mgamota2/ECE427/bringup/media/socket_pcb.jpg

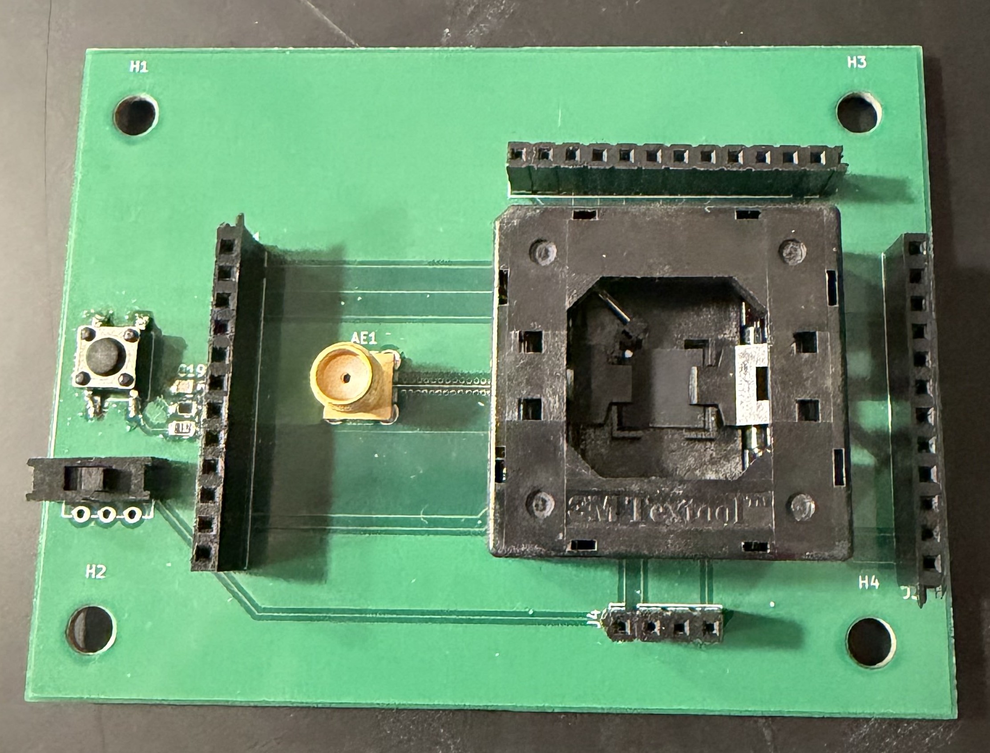
bringup/media/socket_pcb.jpg
