mgamota2/ECE427/bringup/media/distribution_stream.jpg

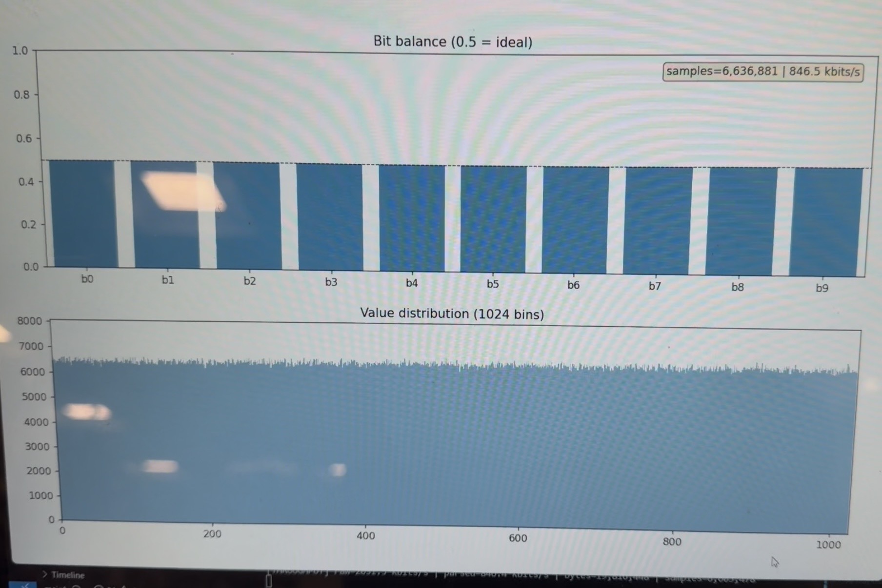
bringup/media/distribution_stream.jpg
