mgamota2/ECE427/bringup/media/legend_gui.png

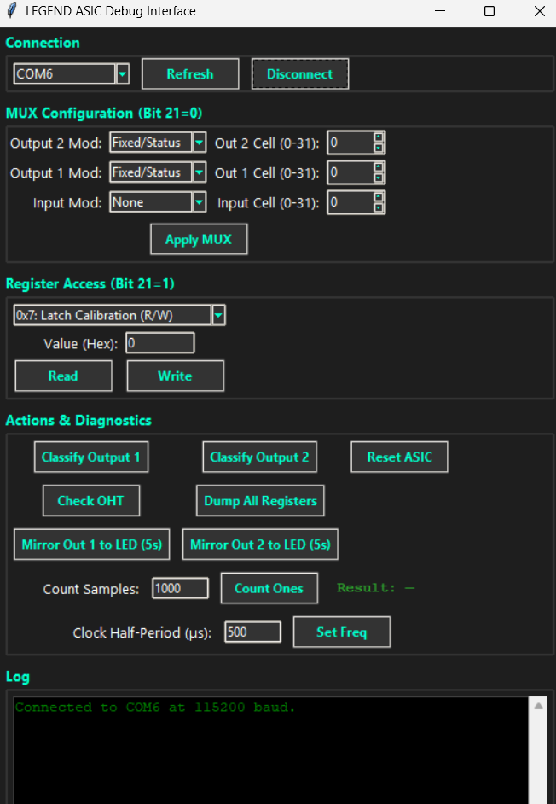
bringup/media/legend_gui.png
