mgamota2/ECE427/bringup/media/pcb_off.jpeg

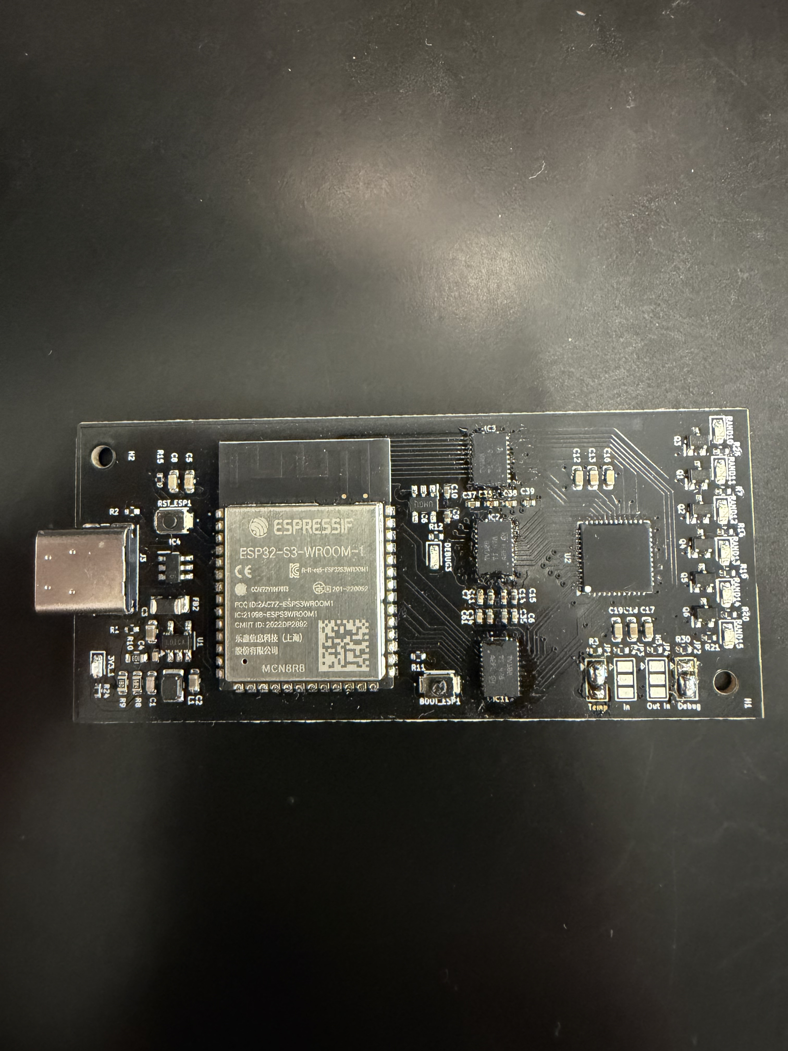
bringup/media/pcb_off.jpeg
