mgamota2/ECE427/bringup/esp32xlegend/esp32xlegend/esp32xlegend.kicad_pcb

## KiCad design bringup/esp32xlegend/esp32xlegend/esp32xlegend.kicad_pcb (2026-06-03)

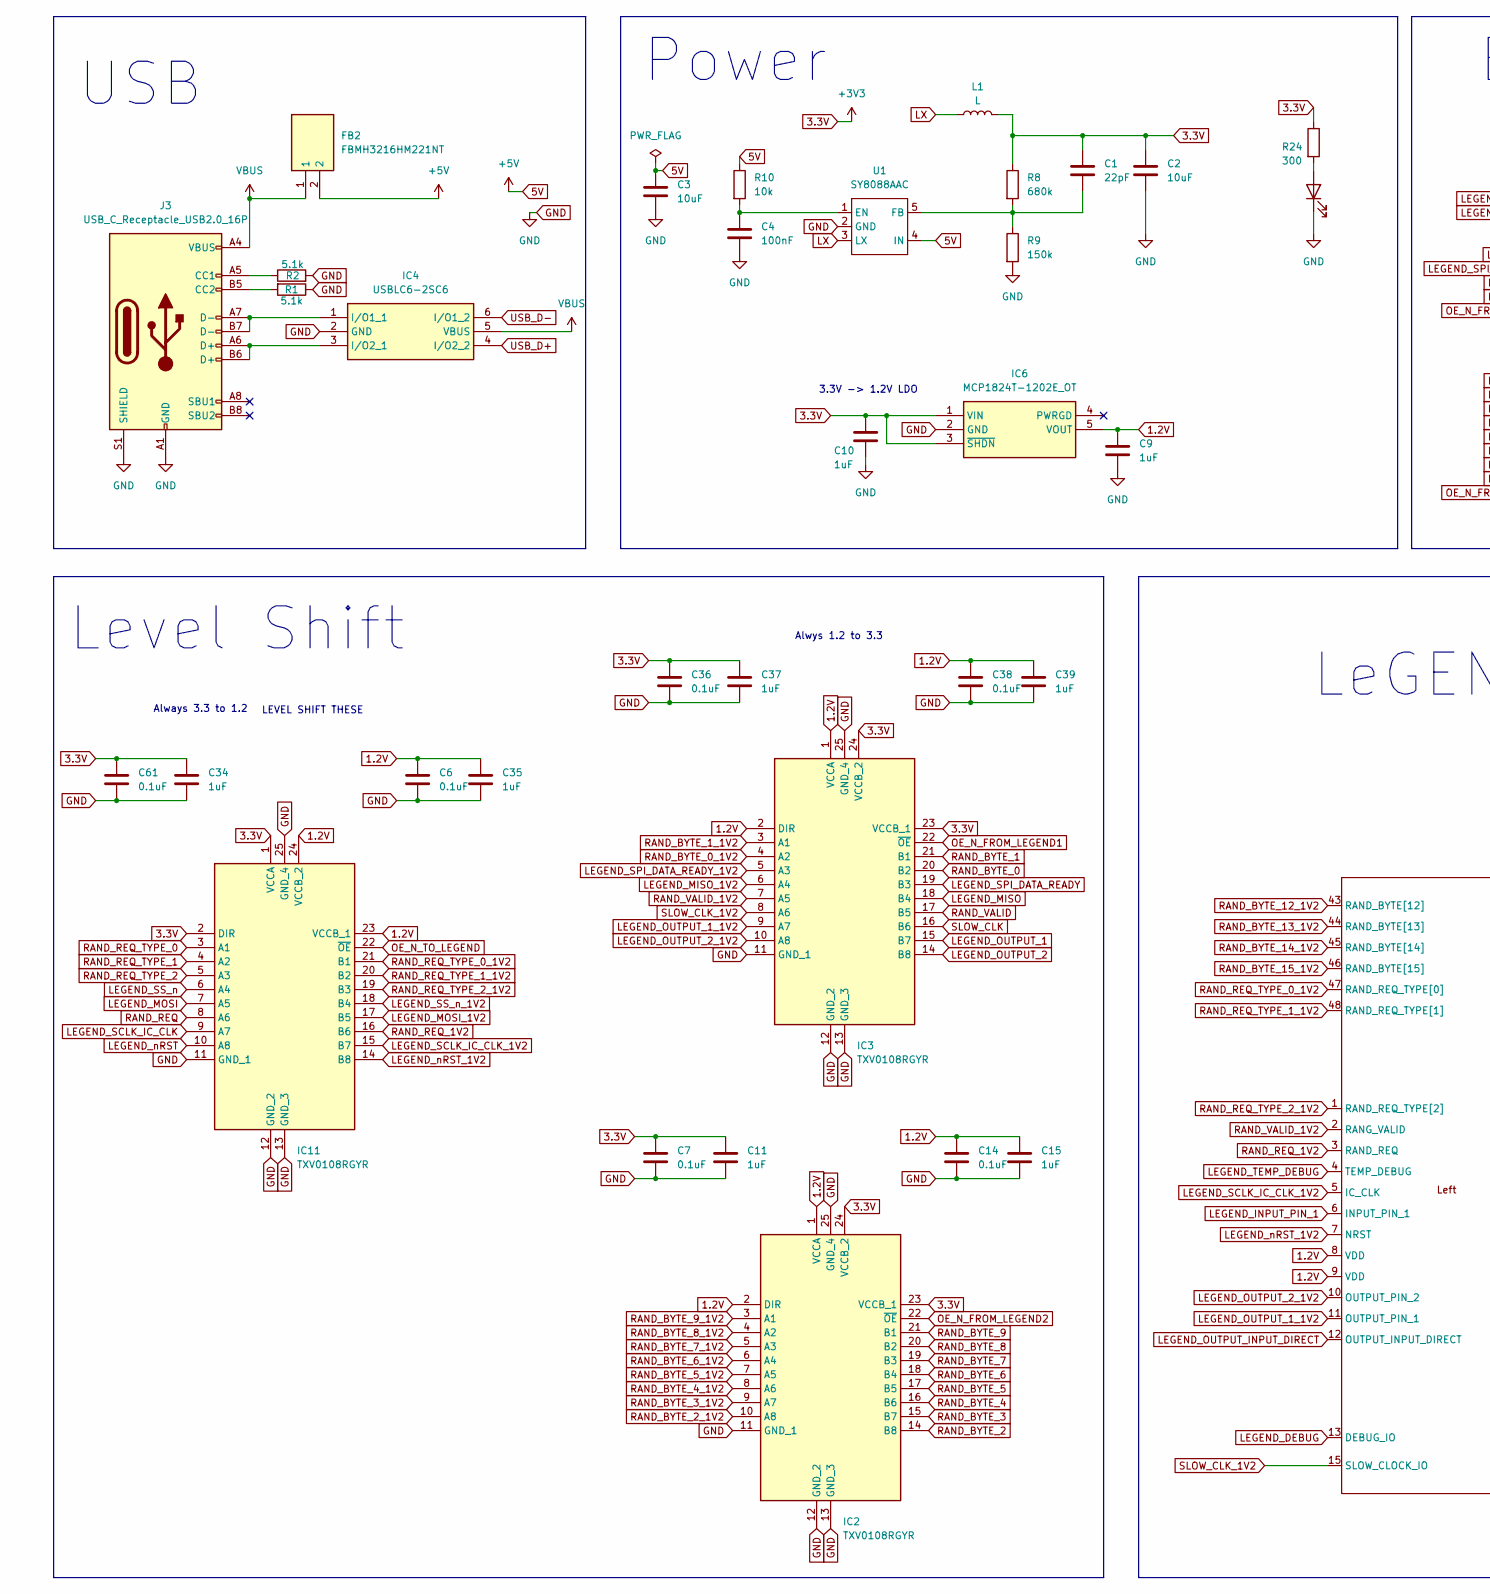
[picture p22: schematic esp32xlegend.kicad_sch, part in row 1, column 1]

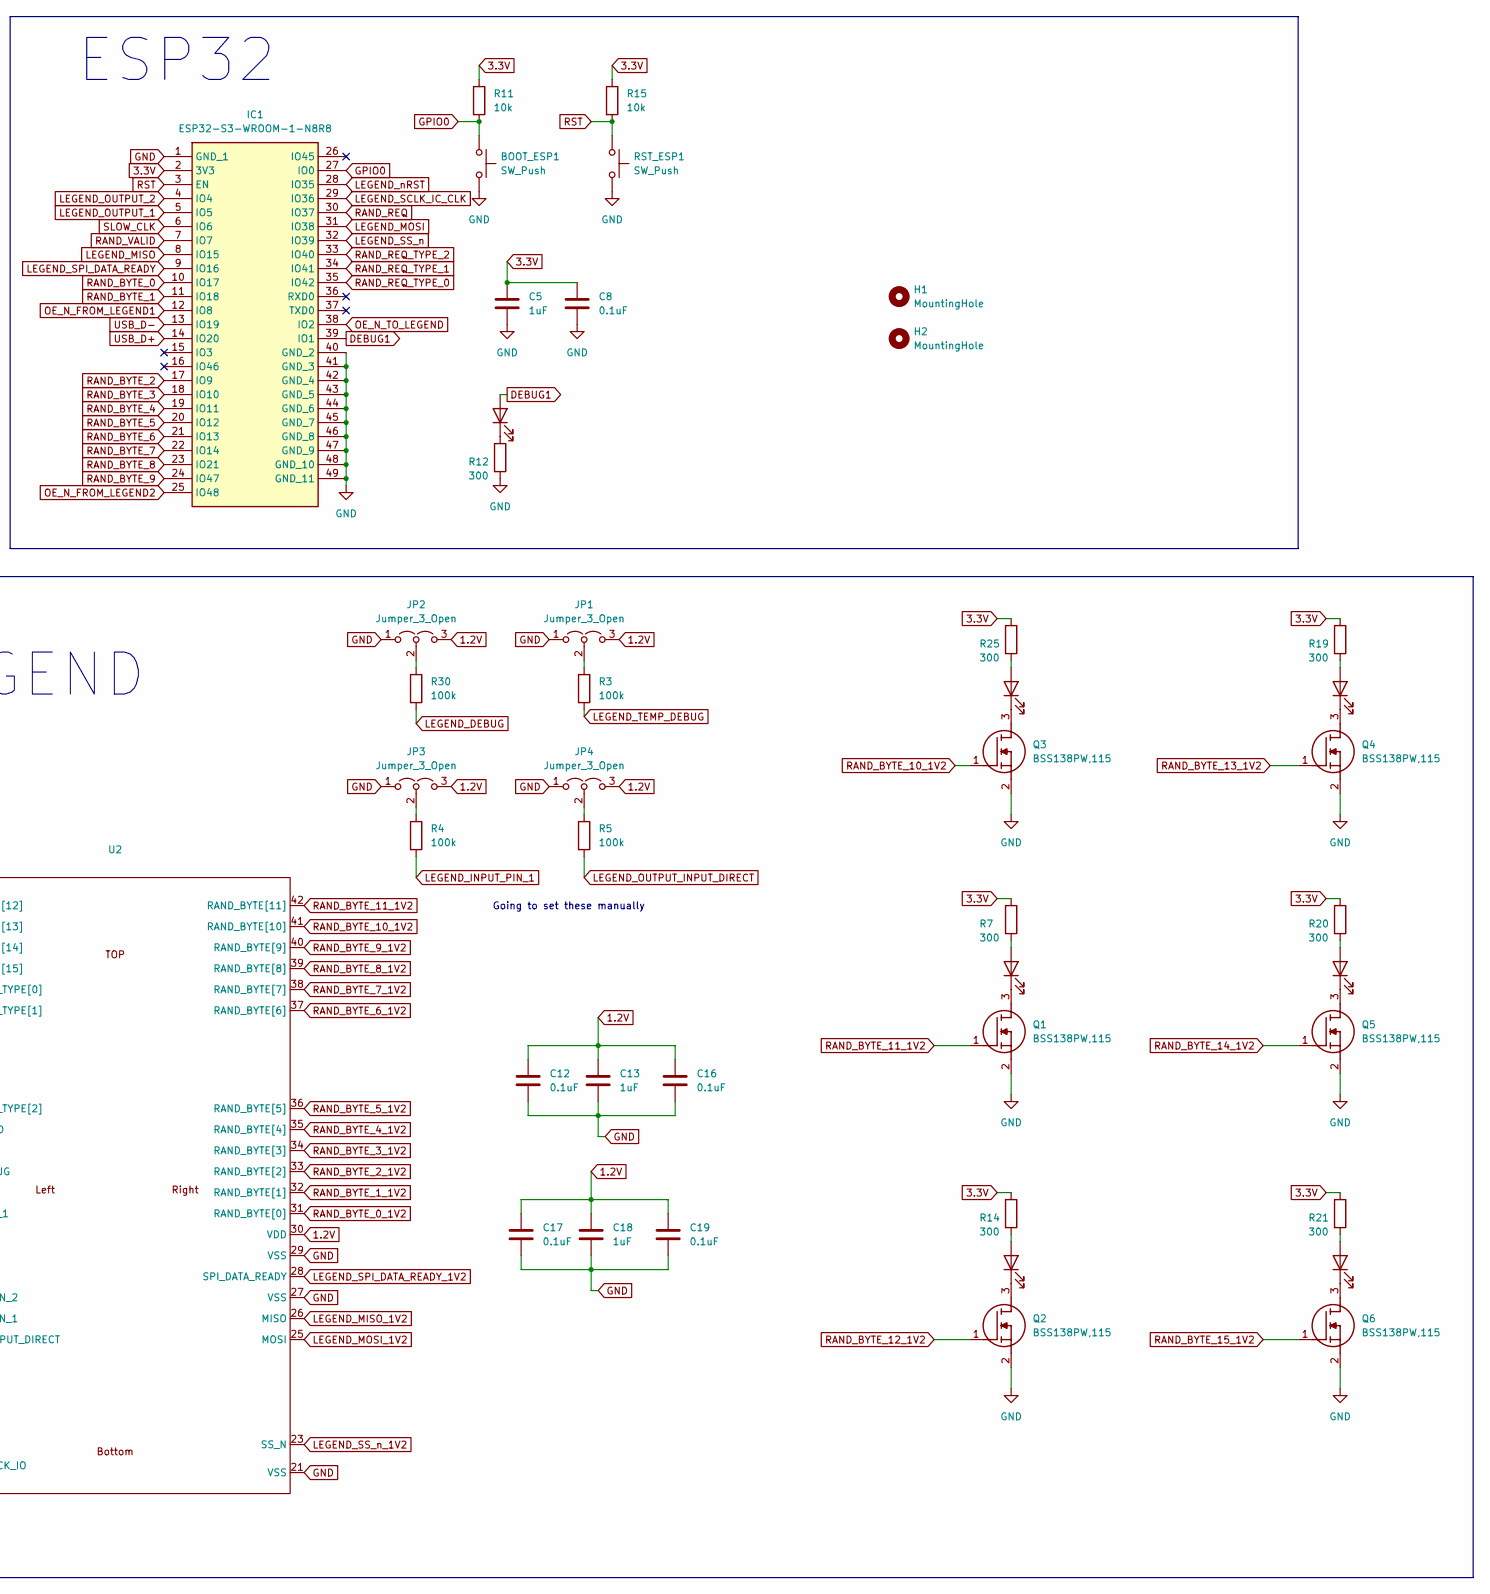
[picture p23: schematic esp32xlegend.kicad_sch, part in row 1, column 2]

Parts:
3V3_1: LED; LED_0603_1608Metric
BOOT_ESP1: SW_Push; B3U1000PM
C1: 22pF; C_0603_1608Metric
C2, C3: 10uF; C_0603_1608Metric
C4: 100nF; C_0402_1005Metric
C5, C13, C18: 1uF; C_0603_1608Metric
C6, C7, C14, C36, C38, C61: 0.1uF; C_0402_1005Metric
C8, C12, C16, C17, C19: 0.1uF; C_0603_1608Metric
C9, C10, C11, C15, C34, C35, C37, C39: 1uF; C_0402_1005Metric
DEBUG3: LED; LED_0603_1608Metric
FB2: FBMH3216HM221NT; BEADC3216X180N; Mouser Part Number 963-FBMH3216HM221NT
H1, H2: MountingHole; MountingHole_2.2mm_M2
IC1: ESP32-S3-WROOM-1-N8R8; ESP32S3WROOM1N8R8; Mouser Part Number 356-EP32S3WROOM1N8R8
IC2, IC3, IC11: TXV0108RGYR; Mouser Part Number 595-TXV0108RGYR
IC4: USBLC6-2SC6; SOT95P280X145-6N; Mouser Part Number 511-USBLC6-2SC6
IC6: MCP1824T-1202E_OT; SOT95P270X145-5N; Mouser Part Number 579-MCP1824T-1202EOT
J3: USB_C_Receptacle_USB2.0_16P; USB_C_Receptacle_GCT_USB4085
JP1, JP2, JP3, JP4: Jumper_3_Open; SolderJumper-3_P1.3mm_Open_Pad1.0x1.5mm
L1: L; L_1008_2520Metric
Q1, Q2, Q3, Q4, Q5, Q6: BSS138PW,115; SOT65P210X110-3N; Mouser Part Number 771-BSS138PW115
R1, R2: 5.1k; R_0402_1005Metric
R3, R4, R5, R30: 100k; R_0402_1005Metric
R7, R12, R14, R19, R20, R21, R24, R25: 300; R_0402_1005Metric
R8: 680k; R_0603_1608Metric
R9: 150k; R_0603_1608Metric
R10: 10k; R_0603_1608Metric
R11, R15: 10k; R_0402_1005Metric
RAND10, RAND11, RAND12, RAND13, RAND14, RAND15: LED; LED_0603_1608Metric
RST_ESP1: SW_Push; B3U1000PM
U1: SY8088AAC; SOT-23-5_HandSoldering
U2: CHIP

Connections:
1.2V: C6.1, C9.1, C12.1, C13.1, C14.1, C15.1, C16.1, C17.1, C18.1, C19.1, C35.1, C38.1, C39.1, IC2.1 (VCCA), IC2.2 (DIR), IC3.1 (VCCA), IC3.2 (DIR), IC6.5 (VOUT), IC11.23 (VCCB_1), IC11.24 (VCCB_2), JP1.3 (B), JP2.3 (B), JP3.3 (B), JP4.3 (B), U2.8 (VDD), U2.9 (VDD), U2.30 (VDD)
3.3V: C1.1, C2.1, C5.1, C7.1, C8.1, C10.1, C11.1, C34.1, C36.1, C37.1, C61.1, IC1.2 (3V3), IC2.23 (VCCB_1), IC2.24 (VCCB_2), IC3.23 (VCCB_1), IC3.24 (VCCB_2), IC6.1 (VIN), IC6.3 (~SHDN), IC11.1 (VCCA), IC11.2 (DIR), L1.2, R7.1, R8.1, R11.1, R14.1, R15.1, R19.1, R20.1, R21.1, R24.1, R25.1
5V: C3.1, FB2.2, R10.1, U1.4 (IN)
DEBUG1: DEBUG3.2 (A), IC1.39 (IO1)
GND: 3V3_1.1 (K), BOOT_ESP1.2, C2.2, C3.2, C4.2, C5.2, C6.2, C7.2, C8.2, C9.2, C10.2, C11.2, C12.2, C13.2, C14.2, C15.2, C16.2, C17.2, C18.2, C19.2, C34.2, C35.2, C36.2, C37.2, C38.2, C39.2, C61.2, IC1.1 (GND_1), IC1.40 (GND_2), IC1.41 (GND_3), IC1.42 (GND_4), IC1.43 (GND_5), IC1.44 (GND_6), IC1.45 (GND_7), IC1.46 (GND_8), IC1.47 (GND_9), IC1.48 (GND_10), IC1.49 (GND_11), IC2.11 (GND_1), IC2.12 (GND_2), IC2.13 (GND_3), IC2.25 (GND_4), IC3.11 (GND_1), IC3.12 (GND_2), IC3.13 (GND_3), IC3.25 (GND_4), IC4.2 (GND), IC6.2 (GND), IC11.11 (GND_1), IC11.12 (GND_2), IC11.13 (GND_3), IC11.25 (GND_4), J3.A1 (GND), J3.A12 (GND), J3.B1 (GND), J3.B12 (GND), J3.S1 (SHIELD), JP1.1 (A), JP2.1 (A), JP3.1 (A), JP4.1 (A), Q1.2 (S), Q2.2 (S), Q3.2 (S), Q4.2 (S), Q5.2 (S), Q6.2 (S), R1.1, R2.2, R9.2, R12.2, RST_ESP1.2, U1.2 (GND), U2.21 (VSS), U2.27 (VSS), U2.29 (VSS)
GPIO0: BOOT_ESP1.1, IC1.27 (IO0), R11.2
LEGEND_DEBUG: R30.2, U2.13 (DEBUG_IO)
LEGEND_INPUT_PIN_1: R4.2, U2.6 (INPUT_PIN_1)
LEGEND_MISO: IC1.8 (IO15), IC3.18 (B4)
LEGEND_MISO_1V2: IC3.6 (A4), U2.26 (MISO)
LEGEND_MOSI: IC1.31 (IO38), IC11.7 (A5)
LEGEND_MOSI_1V2: IC11.17 (B5), U2.25 (MOSI)
LEGEND_OUTPUT_1: IC1.5 (IO5), IC3.15 (B7)
LEGEND_OUTPUT_1_1V2: IC3.9 (A7), U2.11 (OUTPUT_PIN_1)
LEGEND_OUTPUT_2: IC1.4 (IO4), IC3.14 (B8)
LEGEND_OUTPUT_2_1V2: IC3.10 (A8), U2.10 (OUTPUT_PIN_2)
LEGEND_OUTPUT_INPUT_DIRECT: R5.2, U2.12 (OUTPUT_INPUT_DIRECT)
LEGEND_SCLK_IC_CLK: IC1.29 (IO36), IC11.9 (A7)
LEGEND_SCLK_IC_CLK_1V2: IC11.15 (B7), U2.5 (IC_CLK)
LEGEND_SPI_DATA_READY: IC1.9 (IO16), IC3.19 (B3)
LEGEND_SPI_DATA_READY_1V2: IC3.5 (A3), U2.28 (SPI_DATA_READY)
LEGEND_SS_n: IC1.32 (IO39), IC11.6 (A4)
LEGEND_SS_n_1V2: IC11.18 (B4), U2.23 (SS_N)
LEGEND_TEMP_DEBUG: R3.2, U2.4 (TEMP_DEBUG)
LEGEND_nRST: IC1.28 (IO35), IC11.10 (A8)
LEGEND_nRST_1V2: IC11.14 (B8), U2.7 (NRST)
LX: L1.1, U1.3 (LX)
unnamed: 3V3_1.2 (A), R24.2
unnamed: DEBUG3.1 (K), R12.1
unnamed: IC4.1 (I/O1_1), J3.A7 (D-), J3.B7 (D-)
unnamed: IC4.3 (I/O2_1), J3.A6 (D+), J3.B6 (D+)
unnamed: J3.A5 (CC1), R2.1
unnamed: J3.B5 (CC2), R1.2
unnamed: JP1.2 (C), R3.1
unnamed: JP2.2 (C), R30.1
unnamed: JP3.2 (C), R4.1
unnamed: JP4.2 (C), R5.1
unnamed: Q1.3 (D), RAND11.1 (K)
unnamed: Q2.3 (D), RAND12.1 (K)
unnamed: Q3.3 (D), RAND10.1 (K)
unnamed: Q4.3 (D), RAND13.1 (K)
unnamed: Q5.3 (D), RAND14.1 (K)
unnamed: Q6.3 (D), RAND15.1 (K)
unnamed: R25.2, RAND10.2 (A)
unnamed: R7.2, RAND11.2 (A)
unnamed: R14.2, RAND12.2 (A)
unnamed: R19.2, RAND13.2 (A)
unnamed: R20.2, RAND14.2 (A)
unnamed: R21.2, RAND15.2 (A)
unnamed: C4.1, R10.2, U1.1 (EN)
unnamed: C1.2, R8.2, R9.1, U1.5 (FB)
OE_N_FROM_LEGEND1: IC1.12 (IO8), IC3.22 (~OE)
OE_N_FROM_LEGEND2: IC1.25 (IO48), IC2.22 (~OE)
OE_N_TO_LEGEND: IC1.38 (IO2), IC11.22 (~OE)
RAND_BYTE_0: IC1.10 (IO17), IC3.20 (B2)
RAND_BYTE_0_1V2: IC3.4 (A2), U2.31 (RAND_BYTE[0])
RAND_BYTE_1: IC1.11 (IO18), IC3.21 (B1)
RAND_BYTE_1_1V2: IC3.3 (A1), U2.32 (RAND_BYTE[1])
RAND_BYTE_2: IC1.17 (IO9), IC2.14 (B8)
RAND_BYTE_2_1V2: IC2.10 (A8), U2.33 (RAND_BYTE[2])
RAND_BYTE_3: IC1.18 (IO10), IC2.15 (B7)
RAND_BYTE_3_1V2: IC2.9 (A7), U2.34 (RAND_BYTE[3])
RAND_BYTE_4: IC1.19 (IO11), IC2.16 (B6)
RAND_BYTE_4_1V2: IC2.8 (A6), U2.35 (RAND_BYTE[4])
RAND_BYTE_5: IC1.20 (IO12), IC2.17 (B5)
RAND_BYTE_5_1V2: IC2.7 (A5), U2.36 (RAND_BYTE[5])
RAND_BYTE_6: IC1.21 (IO13), IC2.18 (B4)
RAND_BYTE_6_1V2: IC2.6 (A4), U2.37 (RAND_BYTE[6])
RAND_BYTE_7: IC1.22 (IO14), IC2.19 (B3)
RAND_BYTE_7_1V2: IC2.5 (A3), U2.38 (RAND_BYTE[7])
RAND_BYTE_8: IC1.23 (IO21), IC2.20 (B2)
RAND_BYTE_8_1V2: IC2.4 (A2), U2.39 (RAND_BYTE[8])
RAND_BYTE_9: IC1.24 (IO47), IC2.21 (B1)
RAND_BYTE_9_1V2: IC2.3 (A1), U2.40 (RAND_BYTE[9])
RAND_BYTE_10_1V2: Q3.1 (G), U2.41 (RAND_BYTE[10])
RAND_BYTE_11_1V2: Q1.1 (G), U2.42 (RAND_BYTE[11])
RAND_BYTE_12_1V2: Q2.1 (G), U2.43 (RAND_BYTE[12])
RAND_BYTE_13_1V2: Q4.1 (G), U2.44 (RAND_BYTE[13])
RAND_BYTE_14_1V2: Q5.1 (G), U2.45 (RAND_BYTE[14])
RAND_BYTE_15_1V2: Q6.1 (G), U2.46 (RAND_BYTE[15])
RAND_REQ: IC1.30 (IO37), IC11.8 (A6)
RAND_REQ_1V2: IC11.16 (B6), U2.3 (RAND_REQ)
RAND_REQ_TYPE_0: IC1.35 (IO42), IC11.3 (A1)
RAND_REQ_TYPE_0_1V2: IC11.21 (B1), U2.47 (RAND_REQ_TYPE[0])
RAND_REQ_TYPE_1: IC1.34 (IO41), IC11.4 (A2)
RAND_REQ_TYPE_1_1V2: IC11.20 (B2), U2.48 (RAND_REQ_TYPE[1])
RAND_REQ_TYPE_2: IC1.33 (IO40), IC11.5 (A3)
RAND_REQ_TYPE_2_1V2: IC11.19 (B3), U2.1 (RAND_REQ_TYPE[2])
RAND_VALID: IC1.7 (IO7), IC3.17 (B5)
RAND_VALID_1V2: IC3.7 (A5), U2.2 (RANG_VALID)
RST: IC1.3 (EN), R15.2, RST_ESP1.1
SLOW_CLK: IC1.6 (IO6), IC3.16 (B6)
SLOW_CLK_1V2: IC3.8 (A6), U2.15 (SLOW_CLOCK_IO)
USB_D+: IC1.14 (IO20), IC4.4 (I/O2_2)
USB_D-: IC1.13 (IO19), IC4.6 (I/O1_2)
VBUS: FB2.1, IC4.5 (VBUS), J3.A4 (VBUS), J3.A9 (VBUS), J3.B4 (VBUS), J3.B9 (VBUS)

Notes on the sheet:
3.3V -> 1.2V LDO
Power
ESP32
LEVEL SHIFT THESE
Level Shift
Going to set these manually
USB
Alwys 1.2 to 3.3
Always 3.3 to 1.2
LeGEND

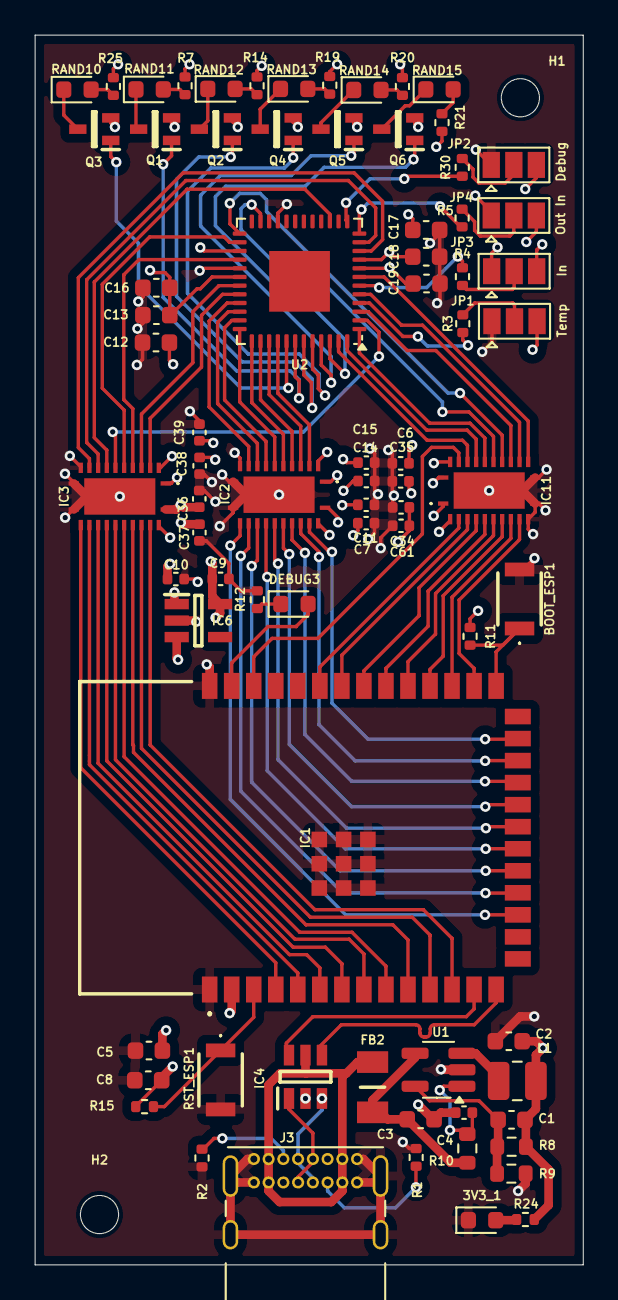
[picture p24: board esp32xlegend.kicad_pcb from above]

Board: 4 copper layers, 31.6 x 70.9 mm, 78 parts (0 on the bottom side), 96 nets.
